Altitude-Tech/Sensly_Project_Files/README.md

# Sensly_Project_Files-
All files required for the production of the Sensly Air Quality Development Board
