Altitude-Tech/Sensly_Project_Files/Bill Of Materials/BME_Module_BOM.csv

Qty | Line Item | Manufacturer | MPN | Octopart URL | Schematic Reference | Internal Part Number | Description | Total Qty (@ Batch Size: 10) | SKU | SKU | SKU | Packaging | Packaging | Packaging | Unit Price (@ Batch Size: 10) | Unit Price (@ Batch Size: 10) | Unit Price (@ Batch Size: 10) | In Stock | In Stock | In Stock | MOQ | MOQ | MOQ | URL | URL | URL | Distributor [Lowest Price (Overall)] | SKU [Lowest Price (Overall)] | Packaging [Lowest Price (Overall)] | Unit Price (@ Batch Size: 10) [Lowest Price (Overall)] | Line Total [Lowest Price (Overall)] | Batch Total [Lowest Price (Overall)] | In Stock [Lowest Price (Overall)] | MOQ [Lowest Price (Overall)] | URL [Lowest Price (Overall)] | Notes
 |  |  |  |  |  |  |  |  | Digi-Key | Mouser | Newark | Digi-Key | Mouser | Newark | Digi-Key | Mouser | Newark | Digi-Key | Mouser | Newark | Digi-Key | Mouser | Newark | Digi-Key | Mouser | Newark
1 | BME280 | Bosch Tools | BME280 | https://octopart.com/bme280-bosch+tools-52931981 | IC2 |  | SENSOR PRESSURE HUMIDITY TEMP | 10 | 828-1063-1-ND | 262-BME280 |  | Cut Tape |  |  | 4.037805156 | 4.7020943200000005 |  | 15767 | 17924 |  | 1 | 1 |  | https://octopart.com/click/track?c=1&ak=39ac400e&sig=0c68ff2&sid=459&ppid=52931981&vpid=265944398&ct=offers | https://octopart.com/click/track?ak=39ac400e&sig=0acb359&sid=2401&ppid=52931981&vpid=244960896&ct=offers |  | Digi-Key | 828-1063-1-ND | Cut Tape | 4.037805156 | 4.037805156 | 40.37805156 | 15767 | 1 | https://octopart.com/click/track?c=1&ak=39ac400e&sig=0c68ff2&sid=459&ppid=52931981&vpid=265944398&ct=offers
2 | C0603C104Z3VACTU | KEMET | C0603C104Z3VACTU | https://octopart.com/c0603c104z3vactu-kemet-98662 | C8, C28 |  | CAP CER 0.1UF 25V Y5V 0603 | 20 | 399-1100-1-ND | 80-C0603C104Z3V | 68X2400 | Cut Tape |  | Cut Tape | 0.027612970000000004 | 0.01183413 | 0.099406692 | 1720606 | 2514461 | 67685 | 1 | 1 | 10 | https://octopart.com/click/track?ak=39ac400e&sig=0007c0d&sid=459&ppid=98662&vpid=1652663&ct=offers | https://octopart.com/click/track?ak=39ac400e&sig=0659022&sid=2401&ppid=98662&vpid=44736930&ct=offers | https://octopart.com/click/track?ak=39ac400e&sig=07e9023&sid=2402&ppid=98662&vpid=314509318&ct=offers | Allied Electronics & Automation | 70095465 | Bulk | 0.003155768 | 0.006311536 | 0.06311536000000001 | 60000 | 1 | https://octopart.com/click/track?ak=39ac400e&sig=00c4327&sid=14&ppid=98662&vpid=74371649&ct=offers
2 | ERJ-3EKF4701V | Panasonic | ERJ-3EKF4701V | https://octopart.com/erj-3ekf4701v-panasonic-9251208 | R1, R2 |  | RES SMD 4.7K OHM 1% 1/10W 0603 | 20 | P4.70KHCT-ND | 667-ERJ-3EKF4701V | 85Y8747 | Cut Tape |  | Cut Tape | 0.051281230000000004 | 0.029979796 | 0.26745133800000004 | 2608291 | 747782 | 70090 | 1 | 1 | 10 | https://octopart.com/click/track?ak=39ac400e&sig=0a29967&sid=459&ppid=9251208&vpid=115259590&ct=offers | https://octopart.com/click/track?ak=39ac400e&sig=0834110&sid=2401&ppid=9251208&vpid=115231443&ct=offers | https://octopart.com/click/track?ak=39ac400e&sig=0e7c89e&sid=2402&ppid=9251208&vpid=268584396&ct=offers | Avnet | ERJ-3EKF4701V |  | 0.00555415168 | 0.01110830336 | 0.1110830336 | 92 | 1 | https://octopart.com/click/track?ak=39ac400e&sig=0163ed9&sid=5822&ppid=9251208&vpid=115343902&ct=offers
1 | M20-9990446 | Harwin | M20-9990446 | https://octopart.com/m20-9990446-harwin-7377378 | JP1 |  | CONN HEADER VERT 4POS 2.54MM | 10 | 952-2266-ND | 855-M20-9990446 |  | Bulk |  |  | 0.141220618 | 0.141220618 |  | 7349 | 5956 |  | 1 | 1 |  | https://octopart.com/click/track?ak=39ac400e&sig=0584972&sid=459&ppid=7377378&vpid=58220075&ct=offers | https://octopart.com/click/track?ak=39ac400e&sig=03d747b&sid=2401&ppid=7377378&vpid=53545504&ct=offers |  | element14 APAC | 1022251 |  | 0.11051468440718021 | 0.11051468440718021 | 1.1051468440718022 | 11279 | 10 | https://octopart.com/click/track?ak=39ac400e&sig=0cc27cb&sid=11744&ppid=7377378&vpid=132290765&ct=offers
