Altitude-Tech/Sensly_Project_Files/Eagle Files/BME Temperature-Humidity-Pressure Board/BME_board-v1-6.brd

## EAGLE design Eagle Files/BME Temperature-Humidity-Pressure Board/BME_board-v1-6.brd (2019-05-31)

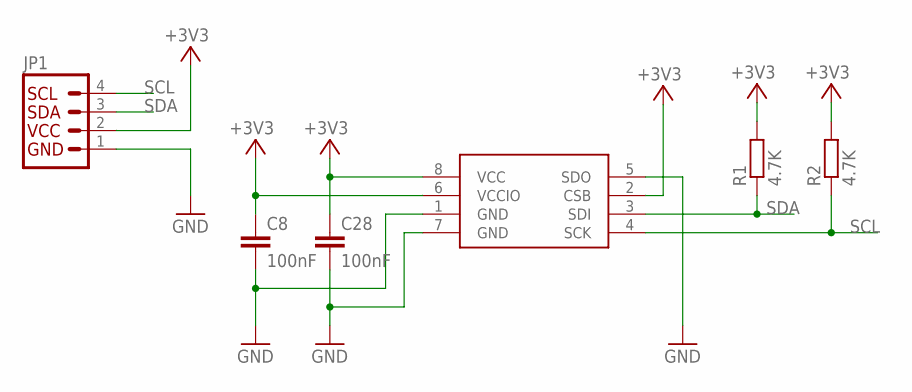
[picture p1: schematic BME_board-v1-6.sch]

Parts:
C8, C28: 100nF; C0603
IC2: BME280
JP1: I2C_STANDARD; 1X04
R1, R2: 4.7K; R0603

Connections:
+3V3: C8.1, C28.1, IC2.2 (CSB), IC2.6 (VCCIO), IC2.8 (VCC), JP1.2, R1.2, R2.2
GND: C8.2, C28.2, IC2.1 (GND), IC2.5 (SDO), IC2.7 (GND), JP1.1
SCL: IC2.4 (SCK), JP1.4, R2.1
SDA: IC2.3 (SDI), JP1.3, R1.1

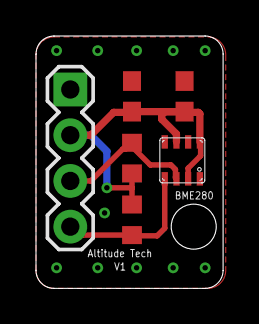
[picture p2: board BME_board-v1-6.brd from above]

Board: 2 copper layers, 10.4 x 14.0 mm, 6 parts (0 on the bottom side), 4 nets.
