Altitude-Tech/Sensly_Project_Files/Eagle Files/Sensly HAT/Sensly_HAT v1.6.brd

## EAGLE design Eagle Files/Sensly HAT/Sensly_HAT v1.6.brd (2019-05-31)

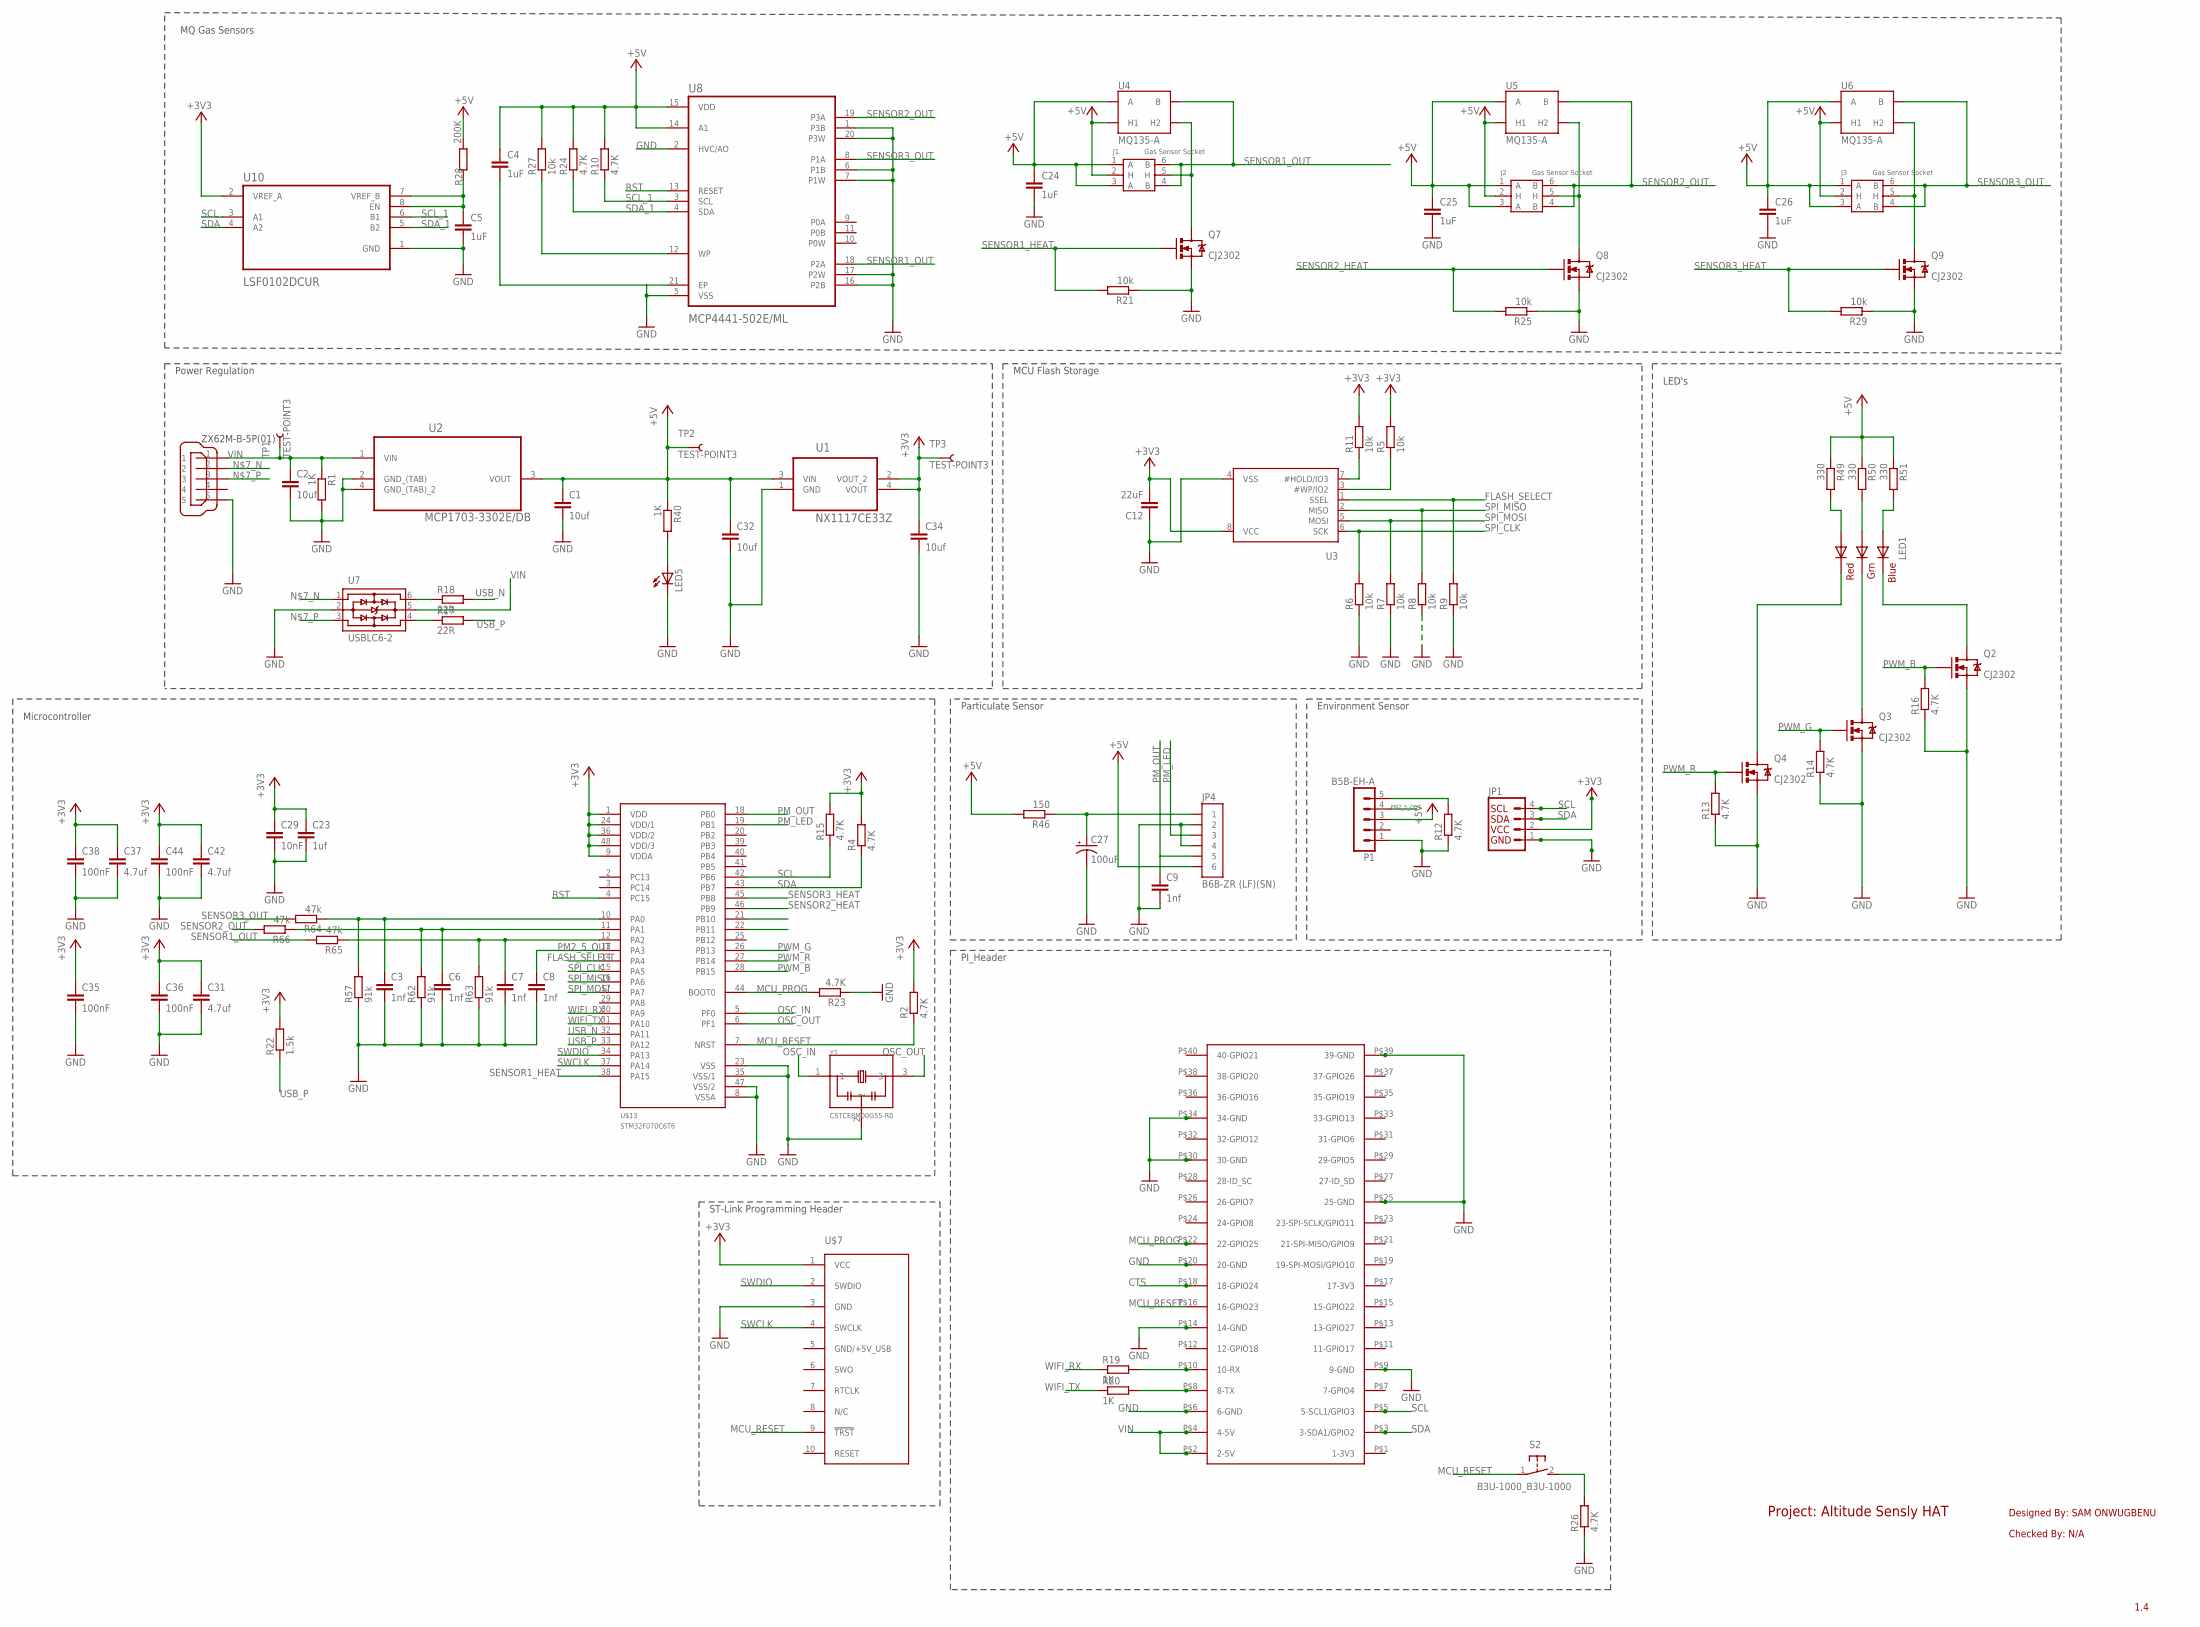
[picture p3: schematic Sensly_HAT v1.6.sch]

Parts:
C1, C2, C32, C34: 10uf; C0603
C3, C6, C7, C8, C9: 1nf; EAGLE-LTSPICE_C0402
C4, C5, C24, C25, C26: 1uF; 0603_N
C12: 22uF; C0603
C23: 1uf; C0603
C27: 100uF; EIA3216
C29: 10nF; C0603
C31, C37, C42: 4.7uf; C0603
C35, C36, C38, C44: 100nF; C0603
J1, J2, J3: Gas Sensor Socket; 6P-D17.6X9.8H
JP1: I2C_STANDARD; 1X04
JP4: B6B-ZR (LF)(SN); CONNECTOR_B6B-ZR
LED1: RGBLED5050
LED5: LEDCHIPLED_0603; CHIPLED_0603
P1: B5B-EH-A
Q2, Q3, Q4, Q7, Q8, Q9: CJ2302; SOT-23-3_N/SSOT-3_N
R1, R19, R20, R40: 1K; R0603
R2, R4, R10, R12, R13, R14, R15, R16, R23, R24, R26: 4.7K; R0603
R5, R6, R7, R8, R9, R11, R21, R25, R27, R29: 10k; R0603
R17, R18: 22R; R0603
R22: 1.5k; R0603
R28: 200K; R0603
R46: 150; R0603
R49, R50, R51: 330; R0603
R57, R62, R63: 91k; R0603
R64, R65, R66: 47k; R0603
S2: B3U-1000_B3U-1000; B3U-1000_B3U
TP1, TP2, TP3: TEST-POINT3; PAD.03X.03
U1: NX1117CE33Z; SOT230P700X180-4N
U2: MCP1703-3302E/DB; SOT230P700X180-4N
U3: SPIFLASH_SOIC8; SOIC8_150MIL
U4, U5, U6: MQ135-A
U7: USBLC6-2; USBLC6-2P6
U8: MCP4441-502E/ML; QFN50P400X400X100-21N
U10: LSF0102DCUR; SOP50P310X90-8N
U$2: RASPBERRY-PI+; RASPBERRY-PI-PLUS-CAM_NOTCH
U$7: TC2050-MCP-NL; TC2030-MCP-NL
U$9: ZX62M-B-5P(01); MICROUSB
U$13: STM32F070C6T6; QFP50P900X900X160-48N
Y1: CSTCE8M00G55-R0; OSC_CSTCE8M00G55-R0

Connections:
+3V3: C12.2, C23.1, C29.1, C31.1, C34.1, C35.1, C36.1, C37.1, C38.1, C42.1, C44.1, JP1.2, R2.2, R4.2, R5.2, R11.2, R15.2, R22.2, TP3.P$1, U1.2 (VOUT_2), U1.4 (VOUT), U3.8 (VCC), U10.2 (VREF_A), U$7.1 (VCC), U$13.1 (VDD), U$13.9 (VDDA), U$13.24 (VDD/1), U$13.36 (VDD/2), U$13.48 (VDD/3)
+5V: C1.1, C4.1, C24.1, C25.1, C26.1, C32.1, J1.1 (A), J1.2 (H), J1.3 (A), J2.1 (A), J2.2 (H), J2.3 (A), J3.1 (A), J3.2 (H), J3.3 (A), JP4.P$6 (6), P1.3, R10.2, R24.2, R27.2, R28.2, R40.1, R46.2, R49.1, R50.1, R51.1, TP2.P$1, U1.3 (VIN), U2.3 (VOUT), U4.1 (A), U4.2 (H1), U4.3 (A), U5.1 (A), U5.2 (H1), U5.3 (A), U6.1 (A), U6.2 (H1), U6.3 (A), U8.14 (A1), U8.15 (VDD)
CTS: U$2.P$18 (18-GPIO24)
FLASH_SELECT: R9.2, U3.1 (SSEL), U$13.14 (PA4)
GND: C1.2, C2.2, C3.2, C4.2, C5.2, C6.2, C7.2, C8.2, C9.2, C12.1, C23.2, C24.2, C25.2, C26.2, C27.C (-), C29.2, C31.2, C32.2, C34.2, C35.2, C36.2, C37.2, C38.2, C42.2, C44.2, JP1.1, JP4.P$2 (2), JP4.P$4 (4), LED5.C, P1.1, Q2.2 (S), Q3.2 (S), Q4.2 (S), Q7.2 (S), Q8.2 (S), Q9.2 (S), R1.2, R6.1, R7.1, R8.1, R9.1, R12.1, R13.1, R14.1, R16.1, R21.1, R23.1, R25.1, R26.1, R29.1, R57.1, R62.1, R63.1, U1.1 (GND), U2.2 (GND_(TAB)), U2.4 (GND_(TAB)_2), U3.4 (VSS), U7.2, U8.1 (P3B), U8.2 (HVC/AO), U8.5 (VSS), U8.6 (P1B), U8.7 (P1W), U8.16 (P2B), U8.17 (P2W), U8.20 (P3W), U8.21 (EP), U10.1 (GND), U$2.P$6 (6-GND), U$2.P$9 (9-GND), U$2.P$14 (14-GND), U$2.P$20 (20-GND), U$2.P$25 (25-GND), U$2.P$30 (30-GND), U$2.P$34 (34-GND), U$2.P$39 (39-GND), U$7.3 (GND), U$9.5, U$13.8 (VSSA), U$13.23 (VSS), U$13.35 (VSS/1), U$13.47 (VSS/2), Y1.2
MCU_PROG: R23.2, U$2.P$22 (22-GPIO25), U$13.44 (BOOT0)
MCU_RESET: R2.1, S2.1, U$2.P$16 (16-GPIO23), U$7.9 (!TRST), U$13.7 (NRST)
unnamed: LED1.5 (RED_C), Q4.3 (D)
unnamed: LED5.A, R40.2
unnamed: P1.5, R12.2
unnamed: R26.2, S2.2
unnamed: U7.1, U$9.2
unnamed: U7.3, U$9.3
unnamed: R19.2, U$2.P$10 (10-RX)
unnamed: R20.2, U$2.P$8 (8-TX)
unnamed: R27.1, U8.12 (WP)
unnamed: R5.1, U3.3 (#WP/IO2)
unnamed: C5.1, R28.1, U10.7 (VREF_B), U10.8 (EN)
unnamed: R18.1, U7.6
unnamed: R17.1, U7.4
unnamed: R11.1, U3.7 (#HOLD/IO3)
unnamed: LED1.4 (BLUE_C), Q2.3 (D)
unnamed: J1.5 (H), Q7.3 (D), U4.5 (H2)
unnamed: LED1.6 (GREEN_C), Q3.3 (D)
unnamed: J2.5 (H), Q8.3 (D), U5.5 (H2)
unnamed: J3.5 (H), Q9.3 (D), U6.5 (H2)
unnamed: C27.A (+), JP4.P$1 (1), R46.1
unnamed: LED1.1 (GREEN_A), R50.2
unnamed: LED1.3 (BLUE_A), R51.2
unnamed: LED1.2 (RED_A), R49.2
OSC_IN: U$13.5 (PF0), Y1.1
OSC_OUT: U$13.6 (PF1), Y1.3
PM2_5_OUT: C8.1, P1.4, U$13.13 (PA3)
PM_LED: JP4.P$3 (3), U$13.19 (PB1)
PM_OUT: C9.1, JP4.P$5 (5), U$13.18 (PB0)
PWM_B: Q2.1 (G), R16.2, U$13.28 (PB15)
PWM_G: Q3.1 (G), R14.2, U$13.26 (PB13)
PWM_R: Q4.1 (G), R13.2, U$13.27 (PB14)
RST: U8.13 (RESET), U$13.4 (PC15)
SCL: JP1.4, R15.1, U10.3 (A1), U$2.P$5 (5-SCL1/GPIO3), U$13.42 (PB6)
SCL_1: R10.1, U8.3 (SCL), U10.6 (B1)
SDA: JP1.3, R4.1, U10.4 (A2), U$2.P$3 (3-SDA1/GPIO2), U$13.43 (PB7)
SDA_1: R24.1, U8.4 (SDA), U10.5 (B2)
SENSOR1_HEAT: Q7.1 (G), R21.2, U$13.38 (PA15)
SENSOR1_OUT: J1.4 (B), J1.6 (B), R65.2, U4.4 (B), U4.6 (B), U8.18 (P2A)
SENSOR1_OUT1: C7.1, R63.2, R65.1, U$13.12 (PA2)
SENSOR2_HEAT: Q8.1 (G), R25.2, U$13.46 (PB9)
SENSOR2_OUT: J2.4 (B), J2.6 (B), R66.2, U5.4 (B), U5.6 (B), U8.19 (P3A)
SENSOR2_OUT1: C6.1, R62.2, R66.1, U$13.11 (PA1)
SENSOR3_HEAT: Q9.1 (G), R29.2, U$13.45 (PB8)
SENSOR3_OUT: J3.4 (B), J3.6 (B), R64.2, U6.4 (B), U6.6 (B), U8.8 (P1A)
SENSOR3_OUT1: C3.1, R57.2, R64.1, U$13.10 (PA0)
SPI_CLK: R6.2, U3.6 (SCK), U$13.15 (PA5)
SPI_MISO: R8.2, U3.2 (MISO), U$13.16 (PA6)
SPI_MOSI: R7.2, U3.5 (MOSI), U$13.17 (PA7)
SWCLK: U$7.4 (SWCLK), U$13.37 (PA14)
SWDIO: U$7.2 (SWDIO), U$13.34 (PA13)
USB_N: R18.2, U$13.32 (PA11)
USB_P: R17.2, R22.1, U$13.33 (PA12)
VIN: C2.1, R1.1, TP1.P$1, U2.1 (VIN), U7.5, U$2.P$2 (2-5V), U$2.P$4 (4-5V), U$9.1
WIFI_RX: R19.1, U$13.30 (PA9)
WIFI_TX: R20.1, U$13.31 (PA10)

Notes on the sheet:
Power Regulation
MQ Gas Sensors
Particulate Sensor
Environment Sensor
1.4
Designed By: SAM ONWUGBENU
Checked By: N/A
Project: Altitude Sensly HAT
MCU Flash Storage
LED's
PI_Header
ST-Link Programming Header
Microcontroller

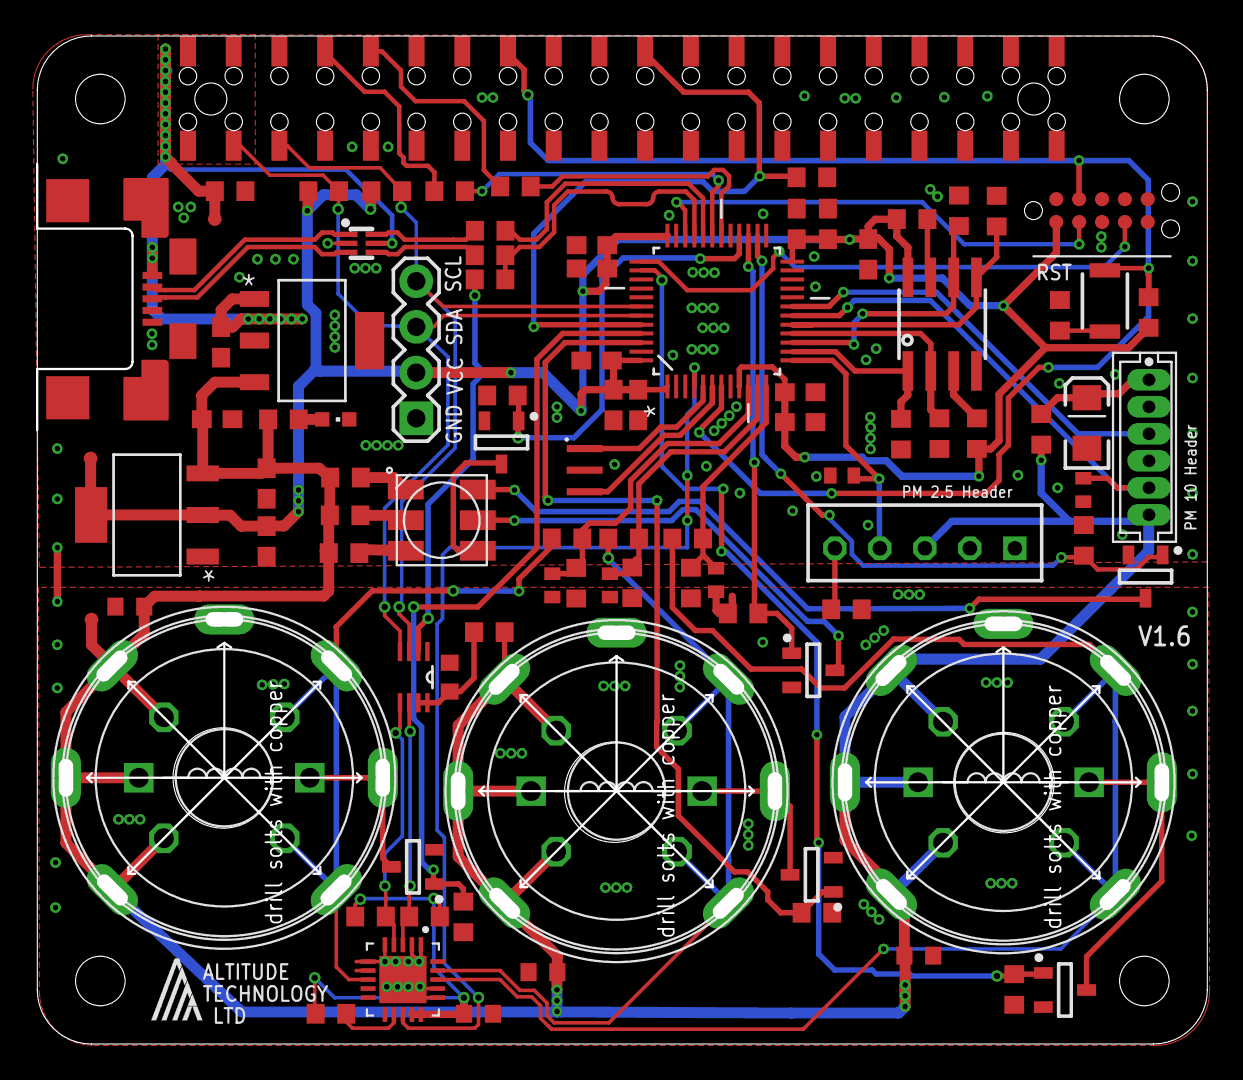
[picture p4: board Sensly_HAT v1.6.brd from above]

Board: 2 copper layers, 65.0 x 56.0 mm, 96 parts (0 on the bottom side), 61 nets.
