Altitude-Tech/Sensly_Project_Files/Firmware/TrueStudio/Sensly_Firmware_HAT_V1-5/Src/main.c

/**
  ******************************************************************************
  * @file           : main.c
  * @brief          : Main program body
  ******************************************************************************
  * This notice applies to any and all portions of this file
  * that are not between comment pairs USER CODE BEGIN and
  * USER CODE END. Other portions of this file, whether 
  * inserted by the user or by software development tools
  * are owned by their respective copyright owners.
  *
  * Copyright (c) 2018 STMicroelectronics International N.V. 
  * All rights reserved.
  *
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
  ******************************************************************************
  */
/* Includes ------------------------------------------------------------------*/
#include "main.h"
#include "stm32f1xx_hal.h"
#include "cmsis_os.h"
#include "adc.h"
#include "dma.h"
#include "i2c.h"
#include "spi.h"
#include "tim.h"
#include "gpio.h"

/* USER CODE BEGIN Includes */
#include "LED.h"
#include "Sensors.h"

/* USER CODE END Includes */


/* USER CODE BEGIN PV */
uint16_t count = 0;
uint8_t flag = 0;
/* USER CODE END PV */

void SystemClock_Config(void);
void MX_FREERTOS_Init(void);
static void MX_NVIC_Init(void);

/* USER CODE BEGIN PFP */

/* USER CODE END PFP */

/**
  * @brief  The application entry point.
  *
  * @retval None
  */
int main(void)
{
  /* MCU Configuration----------------------------------------------------------*/

  /* Reset of all peripherals, Initializes the Flash interface and the Systick. */
  HAL_Init();

  /* Configure the system clock */
  SystemClock_Config();

  /* Initialize all configured peripherals */
  MX_GPIO_Init();
  MX_DMA_Init();
  MX_ADC1_Init();
  MX_SPI1_Init();
  MX_TIM1_Init();
  MX_TIM4_Init();
  MX_I2C1_Init();

  /* Initialize interrupts */
  MX_NVIC_Init();
  /* USER CODE BEGIN 2 */
  LED_Init(&htim1);
  Counter_Init(&htim4);
  HeaterPWM_Init();
  /* USER CODE END 2 */

  /* Call init function for freertos objects (in freertos.c) */
  MX_FREERTOS_Init();

  /* Start scheduler */
  osKernelStart();
  
  /* We should never get here as control is now taken by the scheduler */

  /* Infinite loop */
  /* USER CODE BEGIN WHILE */
  while (1)
  {

  /* USER CODE END WHILE */

  /* USER CODE BEGIN 3 */

  }
  /* USER CODE END 3 */

}

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
/**
  * @brief  Period elapsed callback in non blocking mode
  * @note   This function is called  when TIM3 interrupt took place, inside
  * HAL_TIM_IRQHandler(). It makes a direct call to HAL_IncTick() to increment
  * a global variable "uwTick" used as application time base.
  * @param  htim : TIM handle
  * @retval None
  */
void HAL_TIM_PeriodElapsedCallback(TIM_HandleTypeDef *htim)
{
  if (htim->Instance == TIM3) {
    HAL_IncTick();
  }
  /* USER CODE BEGIN Callback 1 */
  if (htim->Instance == TIM4) {
#ifndef CALIBRATION
	if (count == SENSOR_TIME_LOW && flag == 0)
		{
		  /* Set MQ7 heat pin voltage to 1.4V */
		  //LED_GREEN();
		  __HAL_TIM_SET_COMPARE(&htim4, MQ7HEATPIN, _1_4_V);
		  flag = 1;
		  count = 0;
		}
		/* When the count reaches the SENSOR_TIME_HIGH and the flag has been set to 1, set MQ7 heat pin to 5V */
		else if (count == SENSOR_TIME_HIGH && flag == 1)
		{
		  /* Set MQ7 heat pin voltage to 5V */
		  //LED_BLUE();
		  __HAL_TIM_SET_COMPARE(&htim4, MQ7HEATPIN, FULL_T4);
		  flag = 0;
		  count = 0;
		}
#endif
  	 count++;
  }
  /* When the count reaches the SENSOR_TIME_LOW and the flag has been set to 0, set MQ7 heat pin to 1.4V */

  /* USER CODE END Callback 1 */
}

/**
  * @brief  This function is executed in case of error occurrence.
  * @param  file: The file name as string.
  * @param  line: The line in file as a number.
  * @retval None
  */
void _Error_Handler(char *file, int line)
{
  /* USER CODE BEGIN Error_Handler_Debug */
  /* User can add his own implementation to report the HAL error return state */
  while(1)
  {
  }
  /* USER CODE END Error_Handler_Debug */
}

#ifdef  USE_FULL_ASSERT
/**
  * @brief  Reports the name of the source file and the source line number
  *         where the assert_param error has occurred.
  * @param  file: pointer to the source file name
  * @param  line: assert_param error line source number
  * @retval None
  */
void assert_failed(uint8_t* file, uint32_t line)
{ 
  /* USER CODE BEGIN 6 */
  /* User can add his own implementation to report the file name and line number,
     tex: printf("Wrong parameters value: file %s on line %d\r\n", file, line) */
  /* USER CODE END 6 */
}
#endif /* USE_FULL_ASSERT */

/**
  * @}
  */

/**
  * @}
  */

/************************ (C) COPYRIGHT STMicroelectronics *****END OF FILE****/
