Altitude-Tech/Sensly_Project_Files/Firmware/TrueStudio/Sensly_Firmware_HAT_V1-5/Sensly_Firmware_HAT_V1-5.ioc

Mcu.UserName=STM32F103C8Tx
PA0-WKUP.GPIO_Label=Sensor_Data_1
PA0-WKUP.Signal=ADCx_IN0
PA1.GPIO_Label=Sensor_Data_2
PA1.Signal=ADCx_IN1
PA13.Signal=SYS_JTMS-SWDIO
PA14.Signal=SYS_JTCK-SWCLK
PA15.Signal=GPIO_Output
PA2.GPIO_Label=Sensor_Data_3
PA2.Signal=ADCx_IN2
PA3.GPIO_Label=PM2_5_Out
PA3.Signal=ADCx_IN3
PA4.GPIO_Label=Flash_Select
PA4.Signal=GPIO_Output
PA5.Signal=SPI1_SCK
PA6.Signal=SPI1_MISO
PA7.Signal=SPI1_MOSI
PB0.GPIO_Label=PM_Data
PB0.Signal=ADCx_IN8
PB1.GPIO_Label=PM_LED
PB1.Signal=GPIO_Output
PB13.GPIO_Label=PWM_B
PB13.Signal=TIM1_CH1N
PB14.GPIO_Label=PWM_R
PB14.Signal=TIM1_CH2N
PB15.GPIO_Label=PWM_G
PB15.Signal=TIM1_CH3N
PB6.Signal=I2C1_SCL
PB7.Signal=I2C1_SDA
PB8.Signal=GPIO_Output
PB9.GPIO_Label=Sensor_2_Heat
PB9.Signal=S_TIM4_CH4
PD0-OSC_IN.Signal=RCC_OSC_IN
PD1-OSC_OUT.Signal=RCC_OSC_OUT
