Altitude-Tech/Sensly_Project_Files/Firmware/TrueStudio/Sensly_Firmware_HAT_V1-5/Src/i2c.c

/**
  ******************************************************************************
  * File Name          : I2C.c
  * Description        : This file provides code for the configuration
  *                      of the I2C instances.
  ******************************************************************************
  * This notice applies to any and all portions of this file
  * that are not between comment pairs USER CODE BEGIN and
  * USER CODE END. Other portions of this file, whether 
  * inserted by the user or by software development tools
  * are owned by their respective copyright owners.
  *
  * Copyright (c) 2018 STMicroelectronics International N.V. 
  * All rights reserved.
  *
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
  ******************************************************************************
  */

/* Includes ------------------------------------------------------------------*/
#include "i2c.h"

#include "gpio.h"
#include "dma.h"

I2C_HandleTypeDef hi2c1;
DMA_HandleTypeDef hdma_i2c1_rx;
DMA_HandleTypeDef hdma_i2c1_tx;

/* I2C1 init function */
void MX_I2C1_Init(void)
{

  hi2c1.Instance = I2C1;
  hi2c1.Init.ClockSpeed = 100000;
  hi2c1.Init.DutyCycle = I2C_DUTYCYCLE_2;
  hi2c1.Init.OwnAddress1 = 20;
  hi2c1.Init.AddressingMode = I2C_ADDRESSINGMODE_7BIT;
  hi2c1.Init.DualAddressMode = I2C_DUALADDRESS_DISABLE;
  hi2c1.Init.OwnAddress2 = 0;
  hi2c1.Init.GeneralCallMode = I2C_GENERALCALL_DISABLE;
  hi2c1.Init.NoStretchMode = I2C_NOSTRETCH_DISABLE;
  if (HAL_I2C_Init(&hi2c1) != HAL_OK)
  {
    _Error_Handler(__FILE__, __LINE__);
  }

}

void HAL_I2C_MspInit(I2C_HandleTypeDef* i2cHandle)
{

  GPIO_InitTypeDef GPIO_InitStruct;
  if(i2cHandle->Instance==I2C1)
  {
  
    /**I2C1 GPIO Configuration    
    PB6     ------> I2C1_SCL
    PB7     ------> I2C1_SDA 
    */
    GPIO_InitStruct.Pin = GPIO_PIN_6|GPIO_PIN_7;
    GPIO_InitStruct.Mode = GPIO_MODE_AF_OD;
    GPIO_InitStruct.Speed = GPIO_SPEED_FREQ_HIGH;
    HAL_GPIO_Init(GPIOB, &GPIO_InitStruct);

    /* I2C1 clock enable */
    __HAL_RCC_I2C1_CLK_ENABLE();
  
    /* I2C1 DMA Init */
    /* I2C1_RX Init */
    hdma_i2c1_rx.Instance = DMA1_Channel7;
    hdma_i2c1_rx.Init.Direction = DMA_PERIPH_TO_MEMORY;
    hdma_i2c1_rx.Init.PeriphInc = DMA_PINC_DISABLE;
    hdma_i2c1_rx.Init.MemInc = DMA_MINC_ENABLE;
    hdma_i2c1_rx.Init.PeriphDataAlignment = DMA_PDATAALIGN_BYTE;
    hdma_i2c1_rx.Init.MemDataAlignment = DMA_MDATAALIGN_BYTE;
    hdma_i2c1_rx.Init.Mode = DMA_NORMAL;
    hdma_i2c1_rx.Init.Priority = DMA_PRIORITY_LOW;
    if (HAL_DMA_Init(&hdma_i2c1_rx) != HAL_OK)
    {
      _Error_Handler(__FILE__, __LINE__);
    }

    __HAL_LINKDMA(i2cHandle,hdmarx,hdma_i2c1_rx);

    /* I2C1_TX Init */
    hdma_i2c1_tx.Instance = DMA1_Channel6;
    hdma_i2c1_tx.Init.Direction = DMA_MEMORY_TO_PERIPH;
    hdma_i2c1_tx.Init.PeriphInc = DMA_PINC_DISABLE;
    hdma_i2c1_tx.Init.MemInc = DMA_MINC_ENABLE;
    hdma_i2c1_tx.Init.PeriphDataAlignment = DMA_PDATAALIGN_BYTE;
    hdma_i2c1_tx.Init.MemDataAlignment = DMA_MDATAALIGN_BYTE;
    hdma_i2c1_tx.Init.Mode = DMA_NORMAL;
    hdma_i2c1_tx.Init.Priority = DMA_PRIORITY_LOW;
    if (HAL_DMA_Init(&hdma_i2c1_tx) != HAL_OK)
    {
      _Error_Handler(__FILE__, __LINE__);
    }

    __HAL_LINKDMA(i2cHandle,hdmatx,hdma_i2c1_tx);

    /* I2C1 interrupt Init */
    HAL_NVIC_SetPriority(I2C1_ER_IRQn, 5, 0);
    HAL_NVIC_EnableIRQ(I2C1_ER_IRQn);
  }
}

void HAL_I2C_MspDeInit(I2C_HandleTypeDef* i2cHandle)
{

  if(i2cHandle->Instance==I2C1)
  {
    /* Peripheral clock disable */
    __HAL_RCC_I2C1_CLK_DISABLE();
  
    /**I2C1 GPIO Configuration    
    PB6     ------> I2C1_SCL
    PB7     ------> I2C1_SDA 
    */
    HAL_GPIO_DeInit(GPIOB, GPIO_PIN_6|GPIO_PIN_7);

    /* I2C1 DMA DeInit */
    HAL_DMA_DeInit(i2cHandle->hdmarx);
    HAL_DMA_DeInit(i2cHandle->hdmatx);

    /* I2C1 interrupt Deinit */
    HAL_NVIC_DisableIRQ(I2C1_EV_IRQn);
    HAL_NVIC_DisableIRQ(I2C1_ER_IRQn);
  }
} 

/* USER CODE BEGIN 1 */

/* This function Sends the data pointed to by pData via the I2C peripheral
 * Parameter
 * pData: pointer to sent data buffer
 * Size: Size of data to be sent. Note: can't be bigger than 8 bits / a byte or it won't send. */

void I2C_Send(I2C_HandleTypeDef *hi2c, uint8_t *pData)
{
	if(HAL_I2C_Slave_Transmit_DMA(hi2c, pData, sizeof(uint8_t)) != HAL_OK)
	{
		Error_Handler();
	}

	/* Check that the I2C peripheral is ready for next transmission before exiting while loop */
	while (HAL_I2C_GetState(hi2c) != HAL_I2C_STATE_READY )
	{

	}
}

/* This function sends N number of bytes via the I2C peripheral
 * Parameter
 * RawData: pointer to the read data buffer
 * NumOfBytes: Number of bytes to be sent to enable the data to be split
 */


void I2C_Send_N_Bytes(I2C_HandleTypeDef *hi2c, uint32_t RawData, uint8_t NumOfBytes)
{


	uint8_t TxBuffer[NumOfBytes];
	uint8_t ShiftBy = 8*(NumOfBytes-1);
	uint8_t Transfer = 10;

	for (int i = 0; i < NumOfBytes; i++)
	{
		TxBuffer[i] = 0;

		TxBuffer[i] = (RawData >> ShiftBy) & 0xFF;
		ShiftBy -= 8;

	}
	for (int j = 0; j < NumOfBytes; j++)
	{

		I2C_Send(hi2c, &TxBuffer[j]);
		osDelay(10);
	}

}

/* This function Reads the data via the I2C peripheral and places it in the buffer pointed to by pData
 * Parameter
 * pData: pointer to the read data buffer
 * Size: Size of data to be sent. Note: can't be bigger than 8 bits / a byte or it won't send.
 */


void I2C_Read(I2C_HandleTypeDef *hi2c, uint8_t *pData)
{
	/* HAL Driver i2c send function using DMA protocol */
	if(HAL_I2C_Slave_Receive_DMA(hi2c, pData, 1) != HAL_OK)
	{
		Error_Handler();
	}

	/* Check that the I2C peripheral is ready for next transmission before exiting while loop */
	while (HAL_I2C_GetState(hi2c) != HAL_I2C_STATE_READY )
	{

	}
}

void i2c_delay(void)
{
	osDelay(5);
}

/* This function is called every time there is an error on the i2c bus*/
void HAL_I2C_ErrorCallback(I2C_HandleTypeDef *hi2c)
{

}
/* USER CODE END 1 */

/**
  * @}
  */

/**
  * @}
  */

/************************ (C) COPYRIGHT STMicroelectronics *****END OF FILE****/
