Altitude-Tech/Sensly_Project_Files/(notices)

Notices in the files:
Python Files/Sensly_Test/stm32loader.py:
stm32loader is free software; you can redistribute it and/or modify it under
the terms of the GNU General Public License as published by the Free
parts and their libraries:
microbuilder: This work is placed in the public domain, and may be freely used for commercial and non-commercial work with the following conditions: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
TAG-Connect-TC2050-IDC-NL-SWD-Mode: ©2009 ROFA.cz
con-jst-eh: Copyright (C) 2016, Bob Starr
